ScharreSoft/The-Poor-Mans-Drum-Machine/v3.0/StripBoard/Bass Drum Nein Oh Nein.pdf

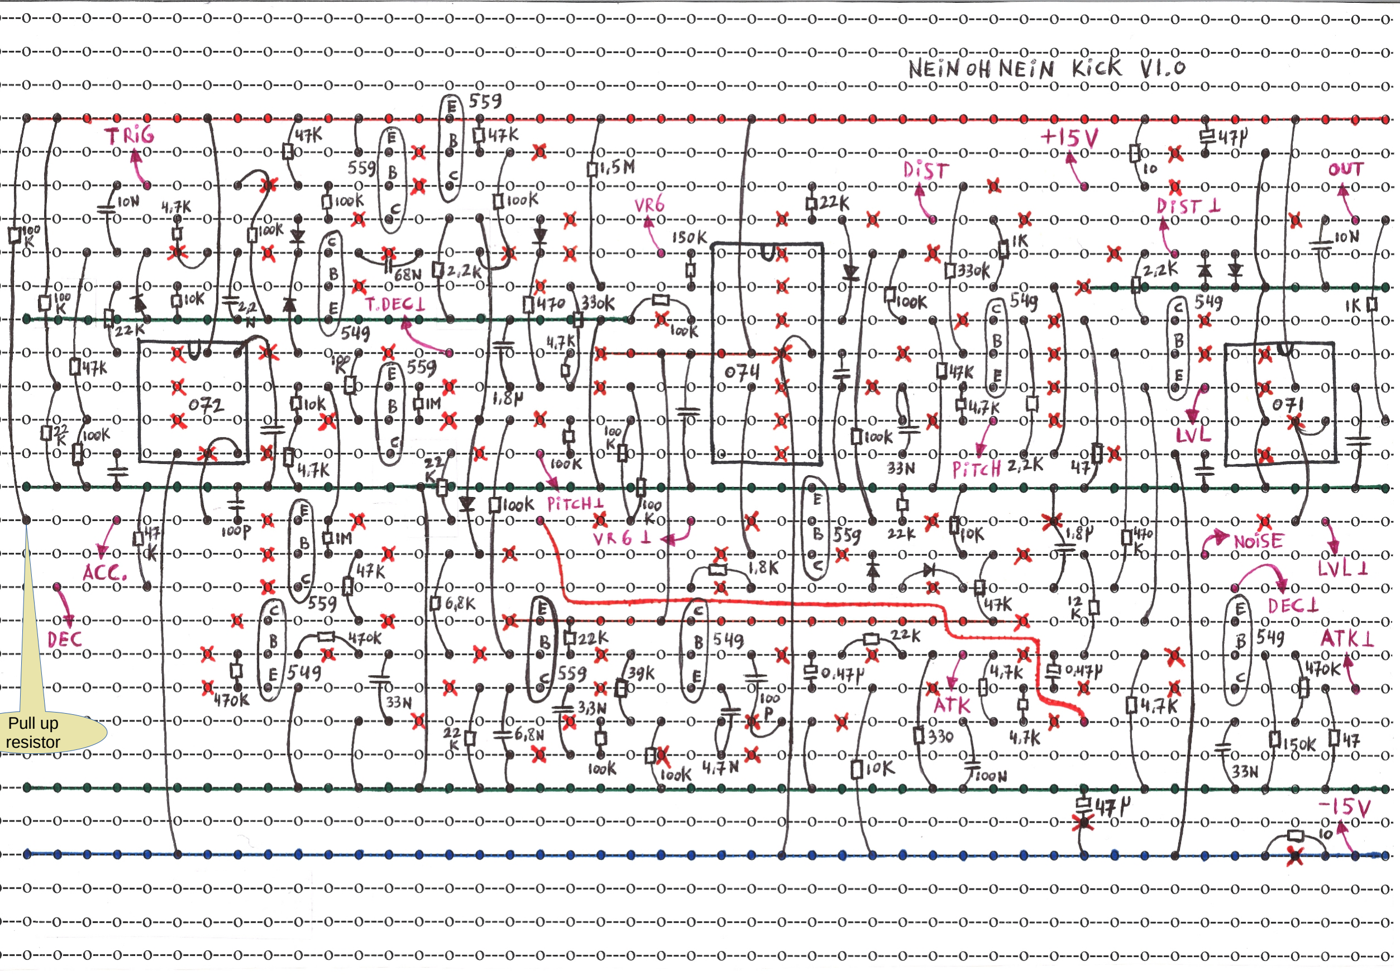
[picture p1: page 1]

Pull up
resistor
