ScharreSoft/The-Poor-Mans-Drum-Machine/v3.0/StripBoard/Low, Mid, High Tom 9090.pdf

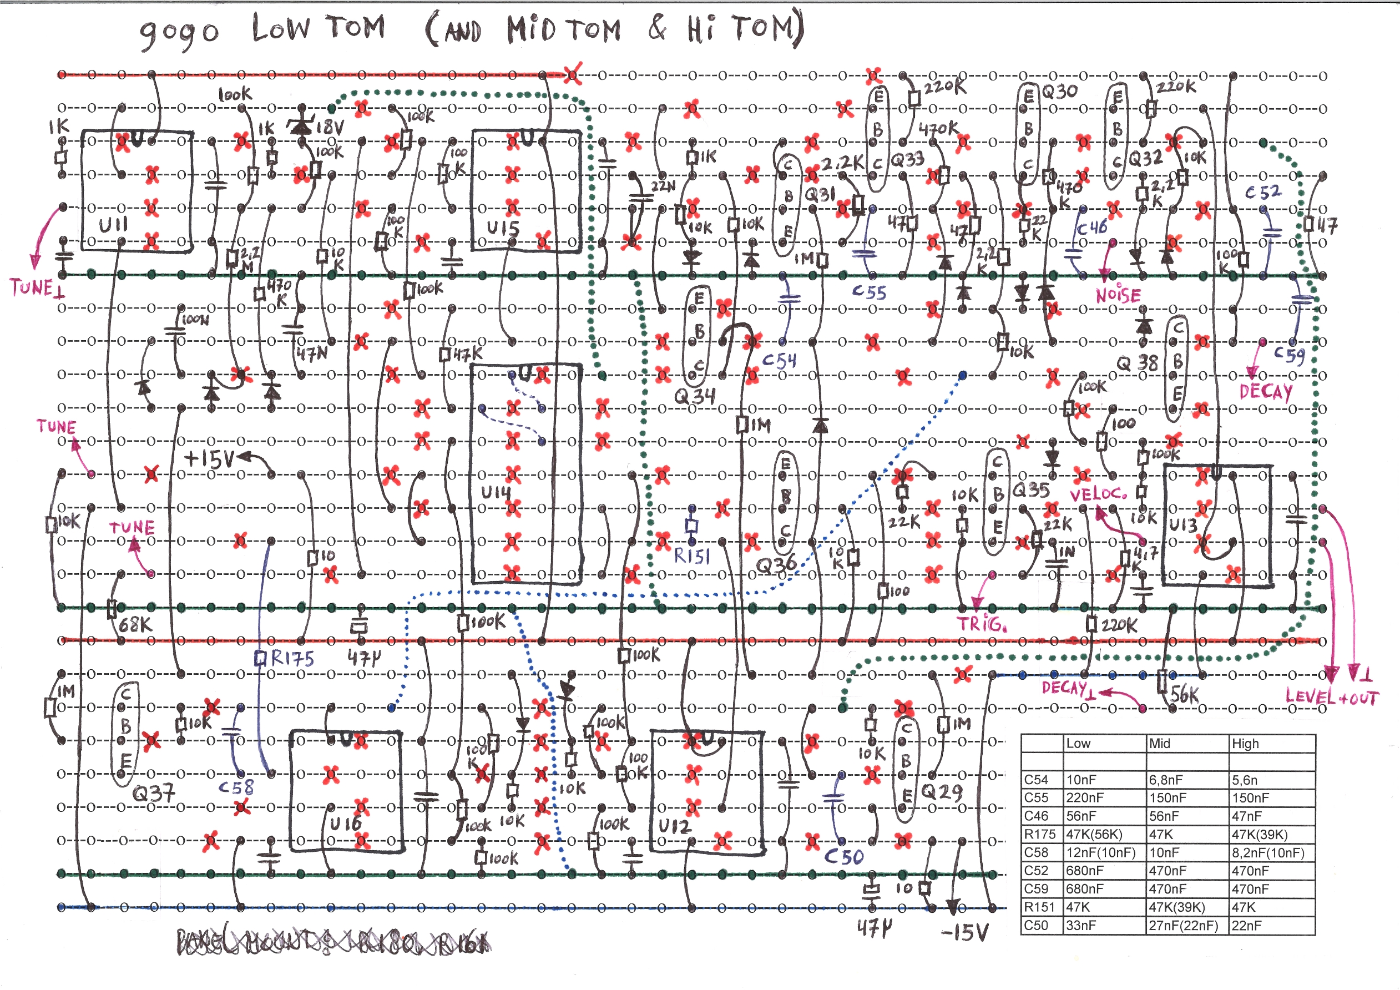
[picture p2: page 1]
