ScharreSoft/The-Poor-Mans-Drum-Machine/v3.0/StripBoard/Noise Source Nein Oh Nein.pdf

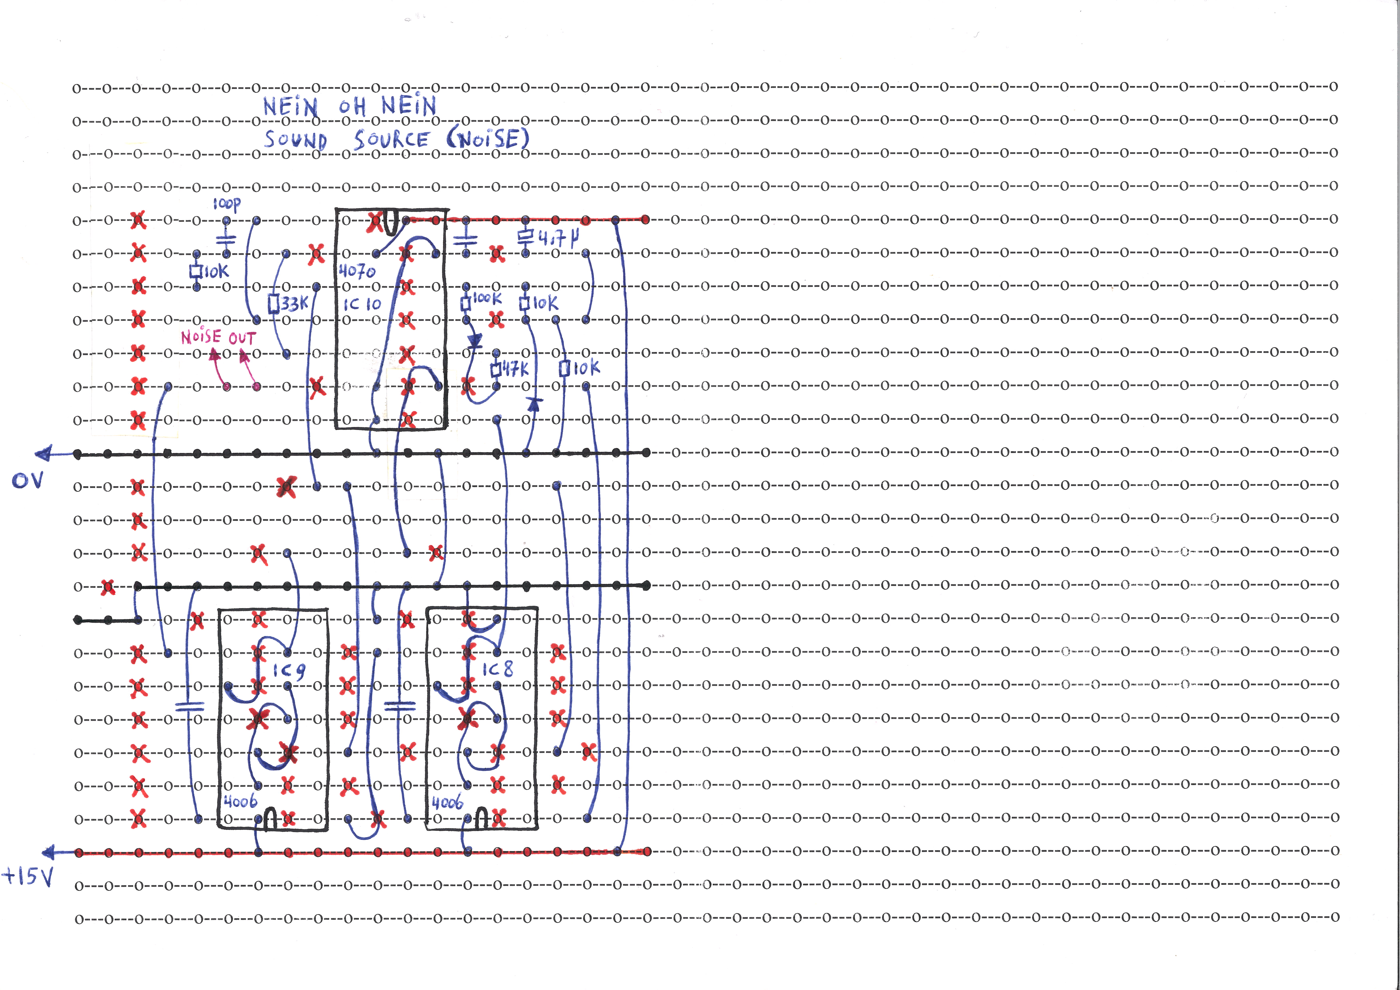
[picture p3: page 1]
