ScharreSoft/The-Poor-Mans-Drum-Machine/v3.0/StripBoard/Rim Shot 9090.pdf

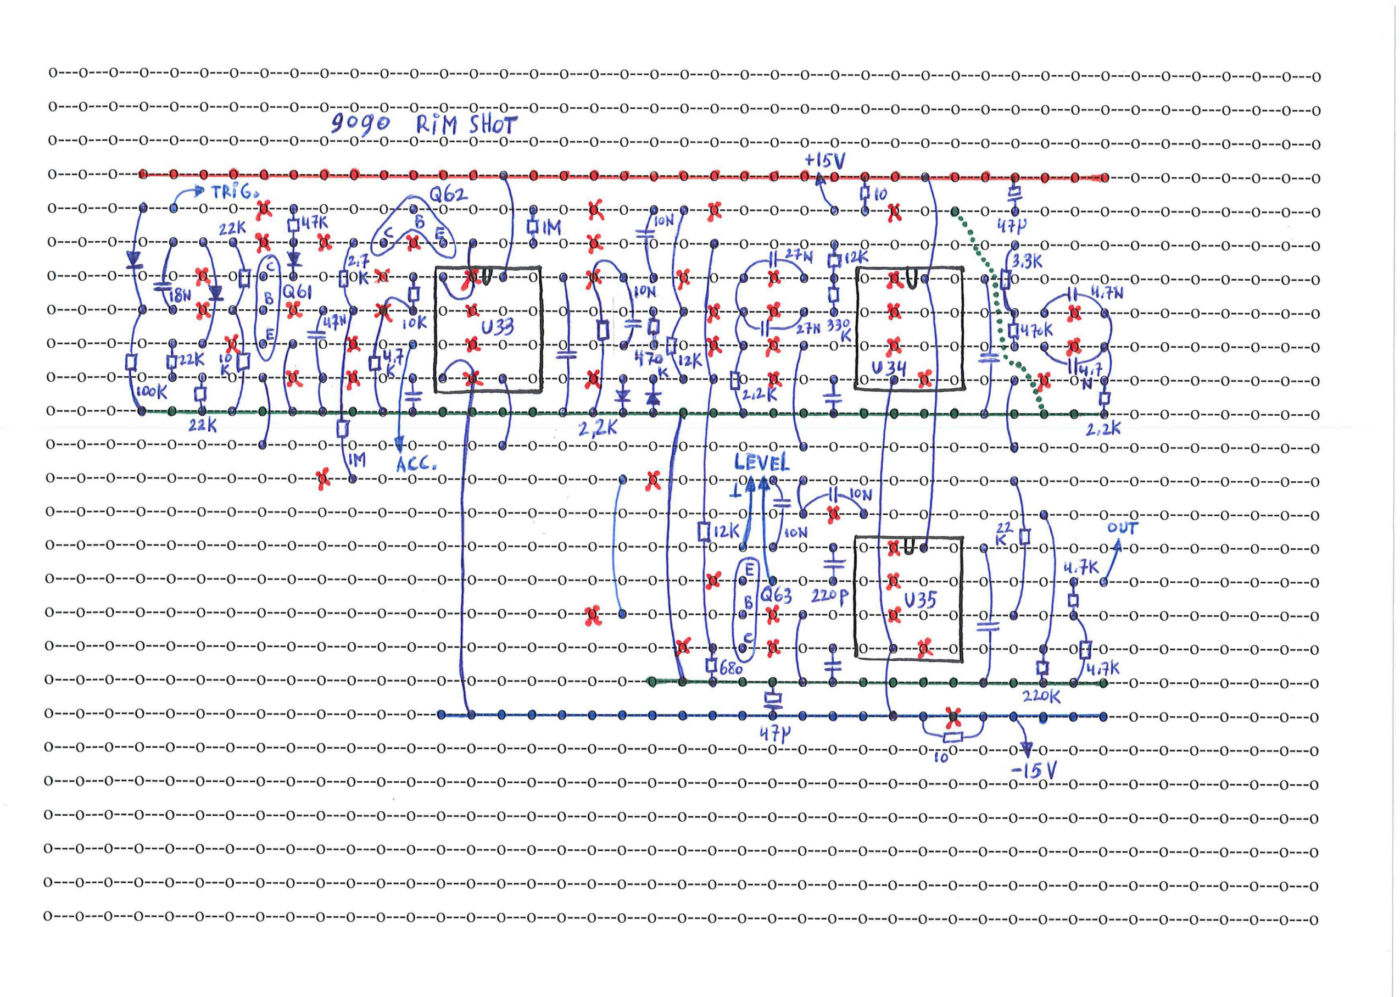
[picture p4: page 1]
