ScharreSoft/The-Poor-Mans-Drum-Machine/v4.1/PMDM Schematic v4.1.0.png

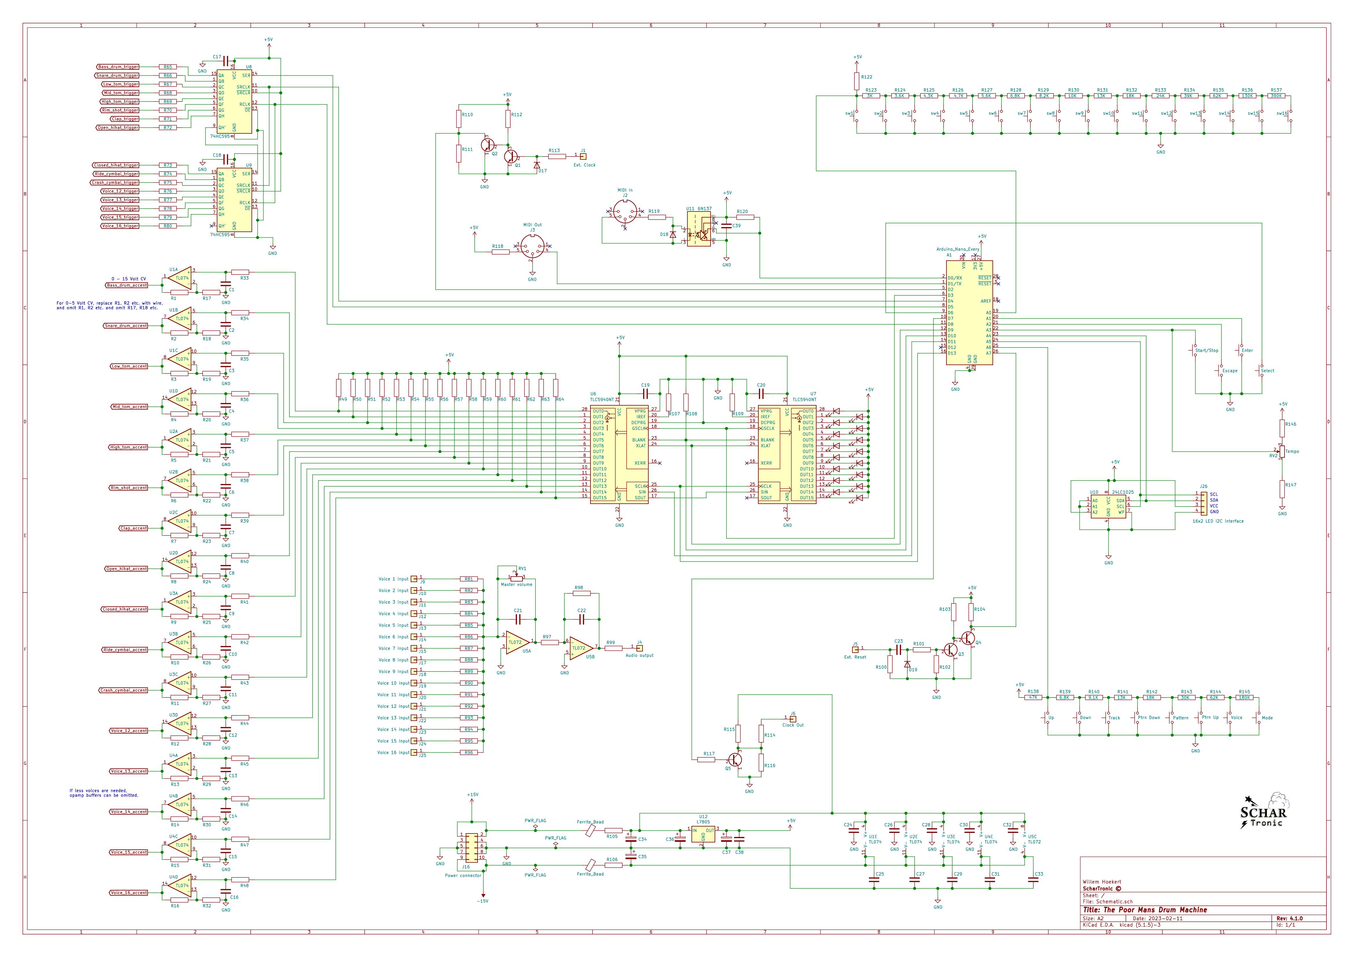
v4.1/PMDM Schematic v4.1.0.png
