ScharreSoft/The-Poor-Mans-Drum-Machine/v4.1/BOM v4.1.0.pdf

The Poor Mans Drum Machine v 4.1.0

R1…R16 | 20K | Q1…Q5 | 2N3904
R17…R32 | 10K
R33…R48 | 10K | C1…C16 | 10nF
R49…R64 | 10K | C17…C20 | 100nF
R65…R80 | 1K | C21,C22 | 10pF
R81…R96 | 47K | C23 | 47nF
R97 | 47K | C24…C33 | 100nF
R98 | 47K | C34 | 47uF
R99 | 1K | C35 | 47uF
R100 | 100K | C36 | 10uF
R101 | 10K | C37 | 10uF
R102 | 100K | C38 | 100nF
R103 | 10K | C39 | 100nF
R104 | 10K
R105,R106 | 10R | D1…D16 | LED
R107,R109 | 7,5K | D17…D19 | 1N4148
R108 | 10K
R110 | 10K | U1…U4 | TL074
R111 | 18K | U5 | TL072
R112 | 10K | U6,U7 | TLC5940
R113 | 47K | U8,U9 | 74HC595
R114 | 1K | U10 | 24LC1025
R115 | 20K | U11 | 6N137
R116 | 10K | U12 | LM7805
R117 | 10K
R118 | 220R | 2 x Potmeter | 50KB
R119 | 220R
R120 | 1,2K | 2 x ferrite beads (optional)
R122 | 47K
R123 | 3K | 16x2 LCD screen with I2C interface
R124 | 3,6K
R125 | 4,3K | A1 | Arduino Nano Every
R126 | 4,7K
R127 | 5,6K
R128 | 6,8K
R129 | 8,2K
R130 | 10K
R131 | 13K
R132 | 18K
R133 | 24K
R134 | 39K
R135 | 62K
R136 | 130K
R137 | 390K
R138 | 47K
R139 | 6,8K
R140 | 9,1K
R141 | 13K
R142 | 18K
R143 | 30K
R144 | 62K
R145 | 180K
R146 | 1K
R147 | 68K
