ScharreSoft/The-Poor-Mans-Drum-Machine/Changelog.txt

v4.2.2 (december 2024)
- Enhanced the MIDI functionality
  It is now possible to connect a MIDI controller (such as a MIDI keyboard) and to play along while the PMDM is playing.
  Removed the MIDI In command from the Mode Menu (the PMDM is now always processing incoming MIDI data).
  MIDI Out: Exporting to a MIDI file is enhanced.

v4.1.1 (april 2023)
- Added two parameters to the config file: USE_ACCENT and LED_Index. 
  It is now possible to configure the PMDM to work without accents. This makes it possible to leave out one TLC5940 (U6), 
  the opamp buffers (U1...U4) and all the associated components. (see build guide for more information).

v4.1 (feb 2023) 
- The name of Poor Man's 909 (PM-909) is changed to Poor Man's Drum Machine (PMDM). 
- The PM-909 and PM-808 schematics are merged into a single PMDM schematic. 
- The schematic is tidied up and all 16 voices are drawn. 
- MIDI in circuit slightly modified (pull up resistor increased to 1,2K, added decoupling capacitor, 10K resistor to ground removed).
- The CV opamp buffers now give a CV range of 0-15 Volt. If only 0-5 Volt CV range is needed,
  two resistors should be omitted per opamp buffer (see schematic for more information). 

v4.0 (nov 2022) 
- Removed the HIHAT_SELECT pin
- Added a Clock Out
- Added a Tempo potmeter
- Changed the iRef resistors on the TLC5940 to 7,5K 
- Added Tap Mode to the firmware
- Added Voice Mute Mode to the firmware
- Several bug fixes

v3.0 (june 2022) 
- Upgraded from 256kB EEPROM to 1025kB EEPROM
- Several bug fixes

v2.0 (march 2022) 
- Added an External Reset input
- Several bug fixes

v1.0 (jan 2022) 
- Release of version 1.0
