ScharreSoft/The-Poor-Mans-Drum-Machine/(threads)

Thread 1 (2023-04-16):

PMDM_config.h

RAWJUNGLE, 2023-04-16:
Hi. Do you have the ability to implement these features in the config file?
1. Add the ability to disable 74HC595 and TLC594NT to make it easier to build and remove unnecessary components.
2. Add the ability to disable Accent.

Thank you.

RAWJUNGLE, 2023-04-18:
1. Yes
2. Yes

RAWJUNGLE, 2023-04-18:
I want to be able to - not connect these chips in the circuit(schematic)

ScharreSoft, 2023-04-18:
But in the end you would connect at least one 74hc595 and one TLC5940 I assume?

RAWJUNGLE, 2023-04-18:
Yes

RAWJUNGLE, 2023-04-18:
1. - 8 instruments (triggers), without accent.
2. - possibility of not connecting inside the circuit, two ic's TLC5940 and 74hc595. (one TLC5940 and 74HC595).

ScharreSoft, 2023-04-19:
About using the circuit without accent:

I assume that you will use at least one TLC5940, because you want to see the LEDs going on and off when you push buttons, right?
If so, you can leave out U6 and all the opamp buffers and associated components. The Arduino pin that was connected to pin 26 of U6 should now be connected to pin 26 of U7.

Next, there should be a firmware update to test it. The problem is that I will not be able to test it, you will have to test it your self.

Have you started building yet? Do you have components?

RAWJUNGLE, 2023-04-19:
I want to make it easier to assemble first.
I don't have the components yet.
You can check it yourself. All you have to do is take the chips out of your board.

I need the buttons to be illuminated and everything to work without accent.
If I do it the way I want, the code won't work because the arduino won't detect the 2 ic's
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

ScharreSoft, 2023-04-20:
I removed U9 and it works fine.
I removed U6 from the circuit and connected Arduino pin D11 to pin 26 from U7.
Made some quick changes to the firmware, it does not work flawless yet as expected. Needs more changes but it should be possible. In the end I am not sure if it would be easier to make a different firmware (PMDM-Light) instead of an option in the config file.

RAWJUNGLE, 2023-04-20:
I think that the code should be made modular, so that it is possible to disable certain IC's.
So that any user could configure the sequencer to suit himself and not distract you unnecessarily.

ScharreSoft, 2023-04-20:
Yes, that would be best and I will try to do that. But I am not sure how many bugs I will encounter and if they are solved easily.

ScharreSoft, 2023-04-23:
Seems like it wasn't that difficult after all. But it still needs some more testing with the different configurations. There is now a variable "USE_ACCENT" in the config file. When set to 0, U6 can (must) be omitted and Arduino pin D11 must be connected to pin 26 from U7.

U9 can be left out without a problem. No changes needed in the firmware, just set MaxVoices to 8.

So it is not really a matter of 'disabling ICs' in the config file. Just leave them out and set USE_ACCENT to 0.

RAWJUNGLE, 2023-04-23:
I just want not to make 4 ic's on PCB, but I want to get by with 2 ic's

RAWJUNGLE, 2023-04-23:
and you haven't updated the code yet.

ScharreSoft, 2023-04-23:
Yes I understand. You can make the circuit as it is in your drawing with one TLC and one 74hc595. I'll update the code after I have tested it thoroughly.

RAWJUNGLE, 2023-04-23:
Thank you, please let me know how to check.

ScharreSoft, 2023-04-26:
What do you mean 'how to check' ?

I have uploaded the new firmware (v4.1.1). There are two new parameters in the config file:

USE_ACCENT
LED_Index

I will update the build guide later, but for now: Arduino pin D11 must be connected to pin 26 from U7 if using only one TLC.

RAWJUNGLE, 2023-04-26:
thanks!

Closed 2023-04-26.
