ScharreSoft/The-Poor-Mans-Drum-Machine/v4.1/PMDM Schematic v4.1.0.pdf

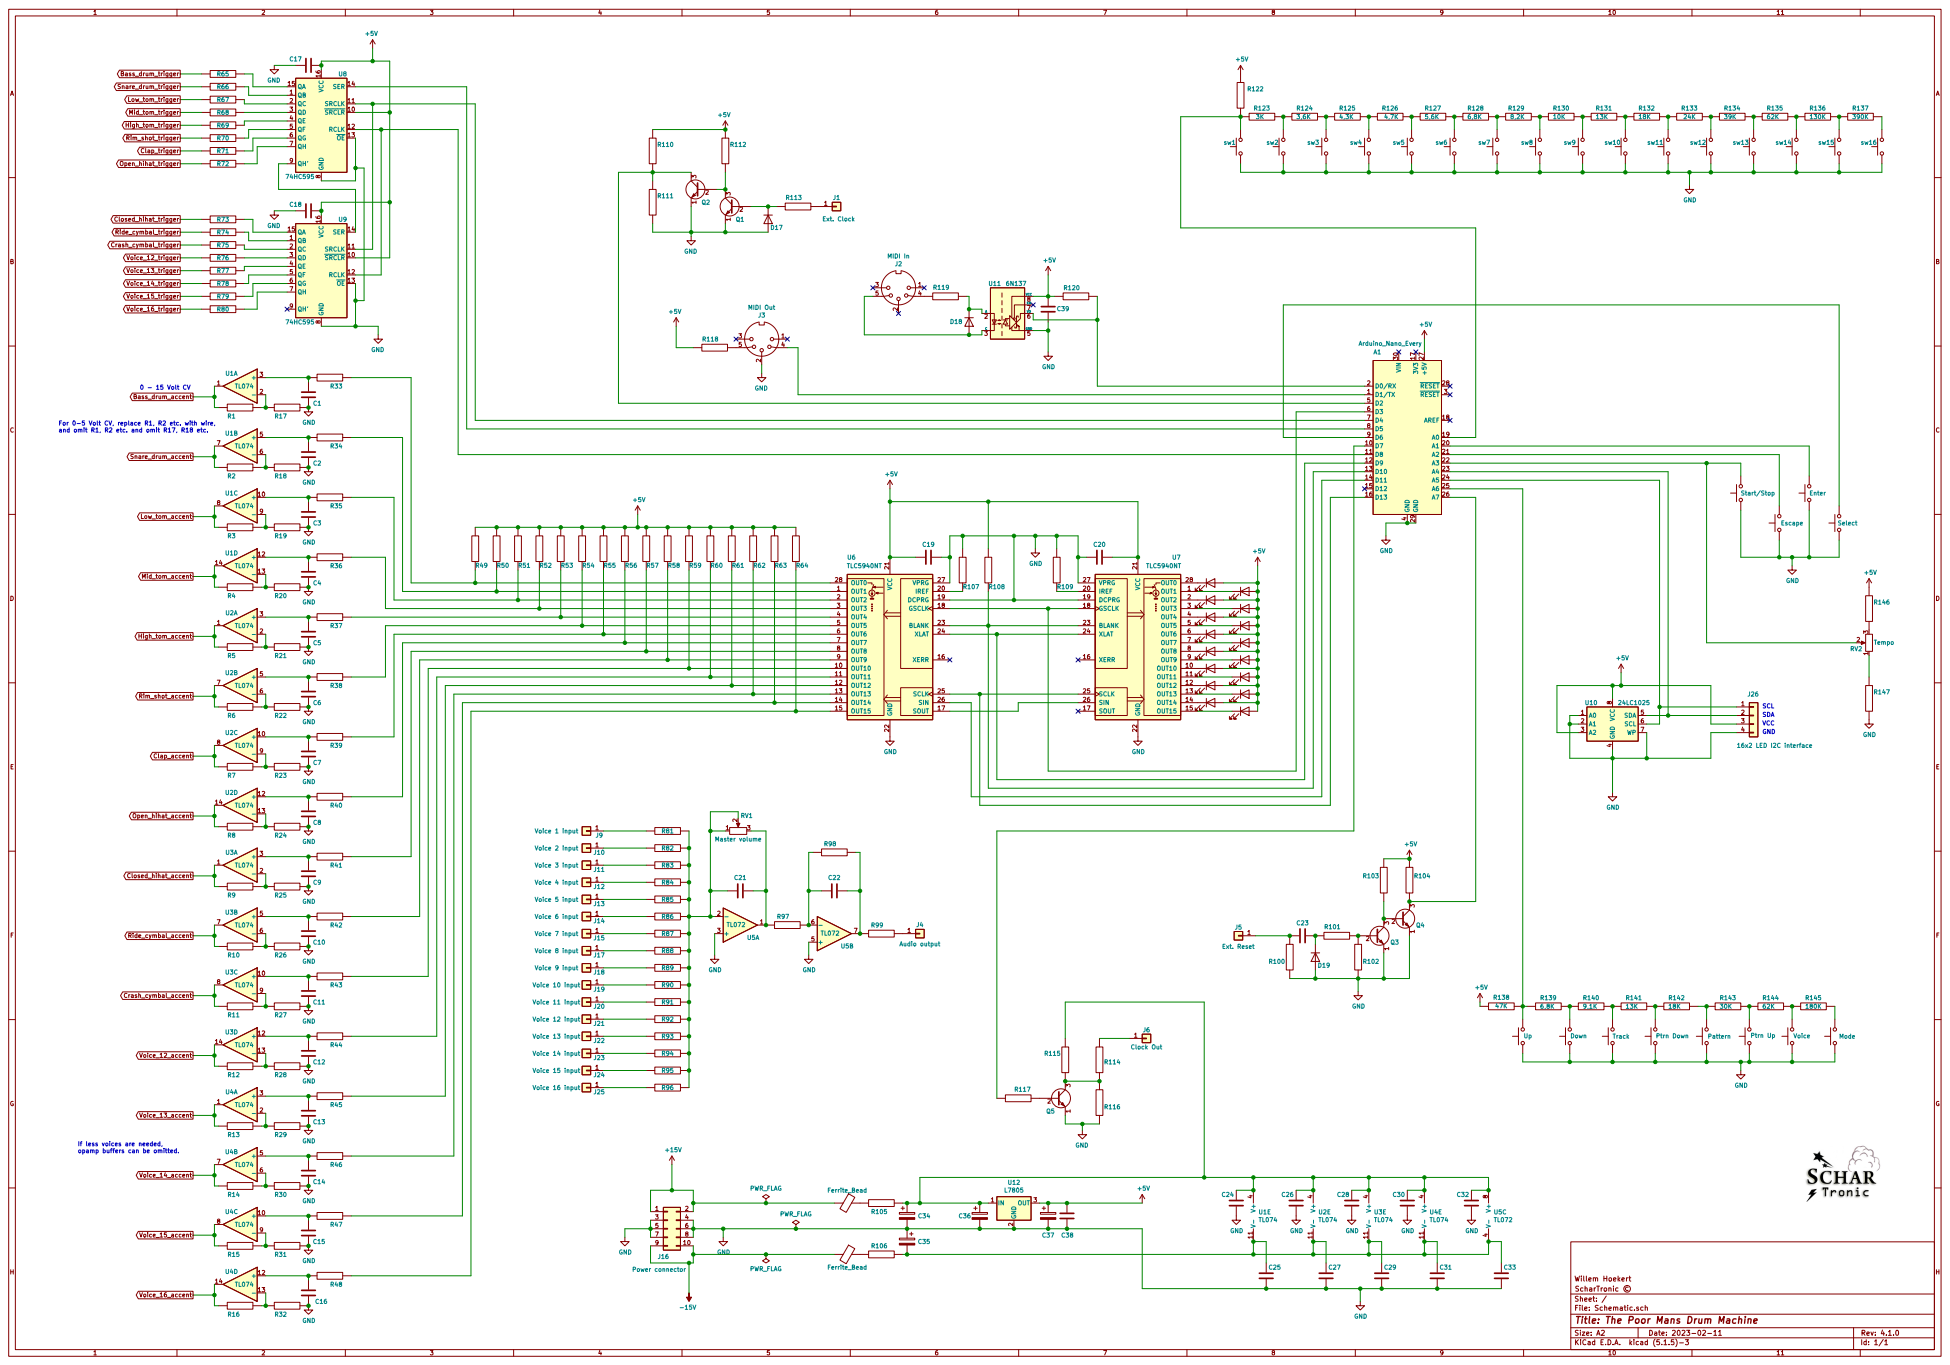
[picture p11: page 1]

9 U7 TLC5940NT 28 OUT3
1 OUT10 3 OUT4

7 OUT8
8 OUT9

10 OUT11

12 OUT13
13 OUT14
14 OUT15

If less voices are needed, opamp buffers can be omitted.

File: Schematic.sch Sheet: / ScharTronic © Willem Hoekert

Id: 1/1 Title: The Poor Mans Drum Machine
