ScharreSoft/The-Poor-Mans-Drum-Machine/v1.0/PM-808 schematic v1.0.pdf

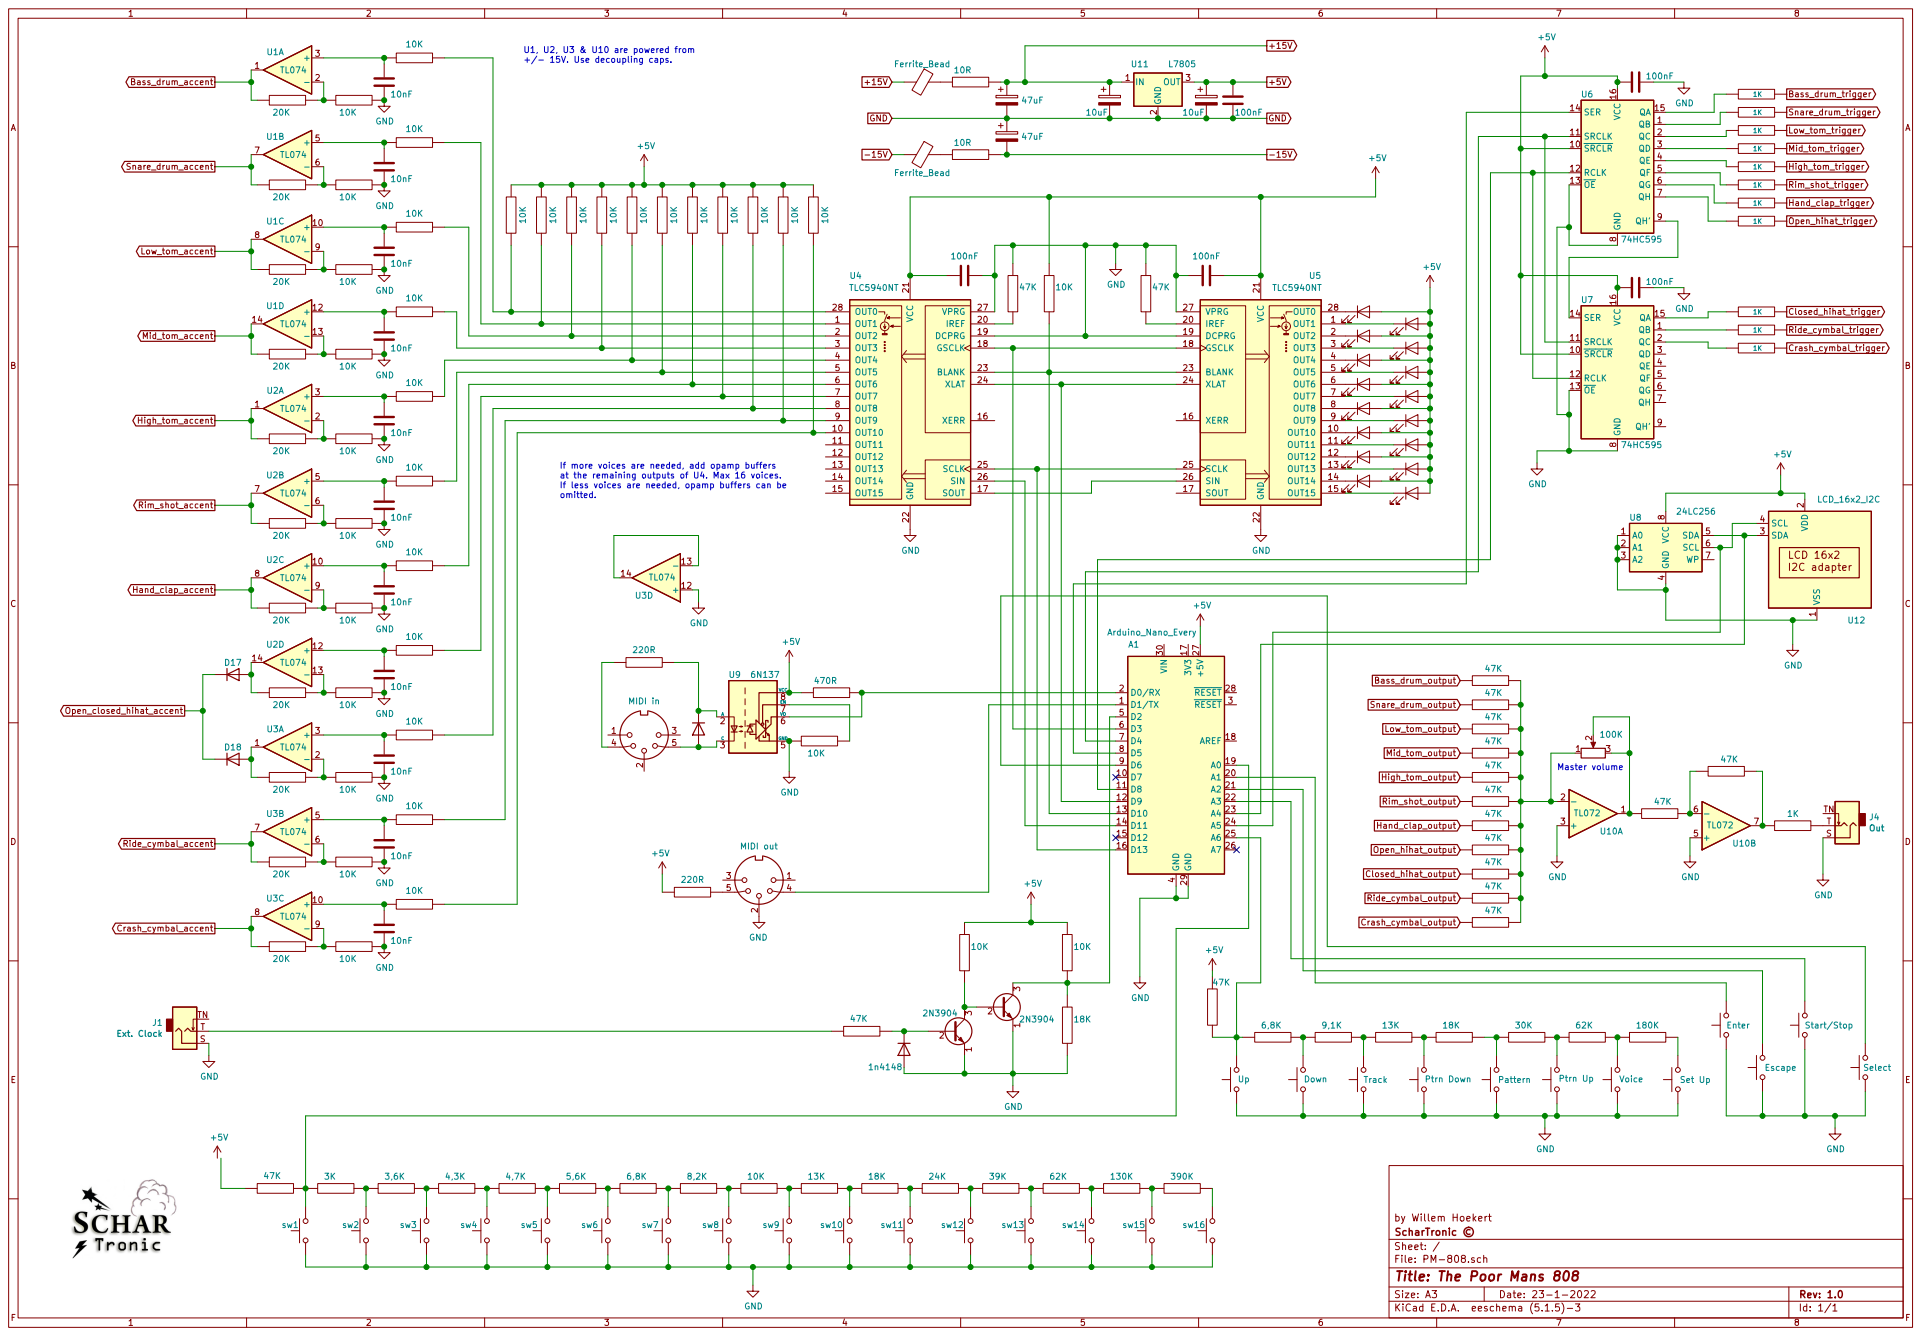
[picture p12: page 1]

47K GND

If more voices are needed, add opamp buffers
at the remaining outputs of U4. Max 16 voices.
If less voices are needed, opamp buffers can be
omitted.

by Willem Hoekert
File: PM-808.sch Sheet: / ScharTronic ©

Id: 1/1 Title: The Poor Mans 808
