ScharreSoft/The-Poor-Mans-Drum-Machine/v4.1/PMDM Schematic v4.1.0.sch

## KiCad design v4.1/PMDM Schematic v4.1.0.sch (2023-02-15)

Schematic: PMDM Schematic v4.1.0.sch

Parts:
A1: Arduino_Nano_Every; Arduino_Nano
C1, C2, C3, C4, C5, C6, C7, C8, C9, C10, C11, C12, C13, C14, C15, C16: 10nF; C_Disc_D10.0mm_W2.5mm_P5.00mm
C17, C18, C32, C33, C38: 100nF; C_Disc_D10.0mm_W2.5mm_P5.00mm
C19, C20, C24, C25, C26, C27, C28, C29, C30, C31, C39: 100nF; C_Disc_D4.3mm_W1.9mm_P5.00mm
C21, C22: 47pF; C_Disc_D3.0mm_W1.6mm_P2.50mm
C23: 47nF; C_Disc_D10.0mm_W2.5mm_P5.00mm
C34, C35: 47uF; CP_Radial_D6.3mm_P2.50mm
C36, C37: 10uF; CP_Radial_D5.0mm_P2.50mm
D1, D2, D3, D4, D5, D6, D7, D8, D9, D10, D11, D12, D13, D14, D15, D16: LED; LED_D3.0mm
D17: 1n4148; D_DO-35_SOD27_P7.62mm_Horizontal
D18, D19: 1n4148; D_DO-35_SOD27_P2.54mm_Vertical_KathodeUp
FB1, FB2: Ferrite_Bead; D_A-405_P5.08mm_Vertical_AnodeUp
J1: Ext. Clock; PinHeader_1x01_P2.54mm_Vertical
J2: MIDI In
J3: MIDI Out
J4: Audio output; PinHeader_1x01_P2.54mm_Vertical
J5: Ext. Reset; PinHeader_1x01_P2.54mm_Vertical
J6: Clock Out; PinHeader_1x01_P2.54mm_Vertical
J9: Voice 1 input; PinHeader_1x01_P2.54mm_Vertical
J10: Voice 2 input; PinHeader_1x01_P2.54mm_Vertical
J11: Voice 3 input; PinHeader_1x01_P2.54mm_Vertical
J12: Voice 4 input; PinHeader_1x01_P2.54mm_Vertical
J13: Voice 5 input; PinHeader_1x01_P2.54mm_Vertical
J14: Voice 6 input; PinHeader_1x01_P2.54mm_Vertical
J15: Voice 7 input; PinHeader_1x01_P2.54mm_Vertical
J16: Power connector
J17: Voice 8 input; PinHeader_1x01_P2.54mm_Vertical
J18: Voice 9 input; PinHeader_1x01_P2.54mm_Vertical
J19: Voice 10 input; PinHeader_1x01_P2.54mm_Vertical
J20: Voice 11 input; PinHeader_1x01_P2.54mm_Vertical
J21: Voice 12 input; PinHeader_1x01_P2.54mm_Vertical
J22: Voice 13 input; PinHeader_1x01_P2.54mm_Vertical
J23: Voice 14 input; PinHeader_1x01_P2.54mm_Vertical
J24: Voice 15 input; PinHeader_1x01_P2.54mm_Vertical
J25: Voice 16 input; PinHeader_1x01_P2.54mm_Vertical
J26: 16x2 LED I2C interface; PinHeader_1x04_P2.54mm_Vertical
Q1, Q2, Q3, Q4, Q5: 2N3904; TO-92_Inline
R1, R2, R3, R4, R5, R6, R7, R8, R9, R10, R11, R12, R13, R14, R15, R16, R115: 20K; R_Axial_DIN0204_L3.6mm_D1.6mm_P2.54mm_Vertical
R17, R18, R19, R20, R21, R22, R23, R24, R25, R26, R27, R28, R29, R30, R31, R32, R33, R34, R35, R36, R37, R38, R39, R40, R41, R42, R43, R44, R45, R46, R47, R48, R49, R50, R101, R103, R104, R108, R110, R112, R116, R117: 10K; R_Axial_DIN0204_L3.6mm_D1.6mm_P2.54mm_Vertical
R51: 10K; R_Axial_DIN0204_L3.6mm_D1.6mm_P5.08mm_Vertical
R52, R130: 10K; R_Axial_DIN0204_L3.6mm_D1.6mm_P7.62mm_Horizontal
R53: 10K; R_Scharre_drie_Horizontal
R54: 10K; R_Scharre_vier_Horizontal
R55: 10K; R_Scharre_vijf_Horizontal
R56: 10K; R_Scharre_zes_Horizontal
R57: 10K; R_Scharre_zeven_Horizontal
R58: 10K; R_Scharre_acht_Horizontal
R59: 10K; R_Scharre_negen_Horizontal
R60: 10K; R_Scharre_tien_Horizontal
R61: 10K; R_Scharre_elf_Horizontal
R62: 10K; R_Scharre_twaalf_Horizontal
R63: 10K; R_Scharre_dertien_Horizontal
R64: 10K; R_Scharre_veertien_Horizontal
R65, R66, R67, R68, R69, R70, R71, R72, R73, R74, R75, R76, R77, R78, R79, R80: 1K; R_Axial_DIN0204_L3.6mm_D1.6mm_P7.62mm_Horizontal
R81, R82, R83, R84, R85, R86, R87, R88, R89, R90, R91, R92, R93, R94, R95, R96, R97, R98, R113: 47K; R_Axial_DIN0204_L3.6mm_D1.6mm_P2.54mm_Vertical
R99, R114, R146: 1K; R_Axial_DIN0204_L3.6mm_D1.6mm_P2.54mm_Vertical
R100, R102: 100K; R_Axial_DIN0204_L3.6mm_D1.6mm_P2.54mm_Vertical
R105, R106: 10R; R_Axial_DIN0204_L3.6mm_D1.6mm_P2.54mm_Vertical
R107, R109: 7,5K; R_Axial_DIN0204_L3.6mm_D1.6mm_P2.54mm_Vertical
R111: 18K; R_Axial_DIN0204_L3.6mm_D1.6mm_P2.54mm_Vertical
R118, R119: 220R; R_Axial_DIN0204_L3.6mm_D1.6mm_P2.54mm_Vertical
R120: 1,2K; R_Axial_DIN0204_L3.6mm_D1.6mm_P2.54mm_Vertical
R122, R138: 47K; R_Axial_DIN0204_L3.6mm_D1.6mm_P7.62mm_Horizontal
R123: 3K; R_Axial_DIN0204_L3.6mm_D1.6mm_P7.62mm_Horizontal
R124: 3,6K; R_Axial_DIN0204_L3.6mm_D1.6mm_P7.62mm_Horizontal
R125: 4,3K; R_Axial_DIN0204_L3.6mm_D1.6mm_P7.62mm_Horizontal
R126: 4,7K; R_Axial_DIN0204_L3.6mm_D1.6mm_P7.62mm_Horizontal
R127: 5,6K; R_Axial_DIN0204_L3.6mm_D1.6mm_P7.62mm_Horizontal
R128, R139: 6,8K; R_Axial_DIN0204_L3.6mm_D1.6mm_P7.62mm_Horizontal
R129: 8,2K; R_Axial_DIN0204_L3.6mm_D1.6mm_P7.62mm_Horizontal
R131, R141: 13K; R_Axial_DIN0204_L3.6mm_D1.6mm_P7.62mm_Horizontal
R132, R142: 18K; R_Axial_DIN0204_L3.6mm_D1.6mm_P7.62mm_Horizontal
R133: 24K; R_Axial_DIN0204_L3.6mm_D1.6mm_P7.62mm_Horizontal
R134: 39K; R_Axial_DIN0204_L3.6mm_D1.6mm_P7.62mm_Horizontal
R135, R144: 62K; R_Axial_DIN0204_L3.6mm_D1.6mm_P7.62mm_Horizontal
R136: 130K; R_Axial_DIN0204_L3.6mm_D1.6mm_P7.62mm_Horizontal
R137: 390K; R_Axial_DIN0204_L3.6mm_D1.6mm_P7.62mm_Horizontal
R140: 9,1K; R_Axial_DIN0204_L3.6mm_D1.6mm_P7.62mm_Horizontal
R143: 30K; R_Axial_DIN0204_L3.6mm_D1.6mm_P7.62mm_Horizontal
R145: 180K; R_Axial_DIN0204_L3.6mm_D1.6mm_P7.62mm_Horizontal
R147: 68K; R_Axial_DIN0204_L3.6mm_D1.6mm_P2.54mm_Vertical
RV1: Master volume
RV2: Tempo
U1, U2, U3, U4: TL074; DIP-14_W7.62mm_Socket
U5: TL072; DIP-8_W7.62mm_Socket
U6, U7: TLC5940NT; DIP-28_W7.62mm
U8, U9: 74HC595; DIP-16_W7.62mm_Socket
U10: 24LC1025; DIP-8_W7.62mm_Socket
U11: 6N137; DIP-8_W7.62mm_Socket
U12: L7805
sw1, sw2, sw3: SW_Push; PB86
sw4, sw5, sw6, sw7, sw8, sw9, sw10, sw11, sw12, sw13, sw14, sw15, sw16: SW_Push; SW_PUSH_6mm_H5mm
sw17: Up; SW_PUSH_6mm_H5mm
sw18: Down; SW_PUSH_6mm_H5mm
sw19: Track; SW_PUSH_6mm_H5mm
sw20: Pattern; SW_PUSH_6mm_H5mm
sw21: Ptrn Up; SW_PUSH_6mm_H5mm
sw22: Voice; SW_PUSH_6mm_H5mm
sw23: Mode; SW_PUSH_6mm_H5mm
sw24: Enter; SW_PUSH_6mm_H5mm
sw25: Escape; SW_PUSH_6mm_H5mm
sw26: Start/Stop; SW_PUSH_6mm_H5mm
sw27: Select; SW_PUSH_6mm_H5mm
sw28: Ptrn Down; SW_PUSH_6mm_H5mm

Notes on the sheet:
If less voices are needed, opamp buffers can be omitted.
SCL
SDA
VCC
GND
For 0-5 Volt CV, replace R1, R2 etc. with wire, and omit R1, R2 etc. and omit R17, R18 etc.
0 - 15 Volt CV
