ScharreSoft/The-Poor-Mans-Drum-Machine/(commit log)

2023-02-11 Rename Schematic.sch to PMDM Schematic v4.1.0.sch
    [PMDM Schematic v4.1.0.sch]
2023-02-12 Rename Schematic.sch to PMDS Schematic v4.1.0.sch
    [PMDS Schematic v4.1.0.sch]
